VWarlock/MSX_WozBlaster/Images/Wozblaster_v1.2_PCB_top.jpg

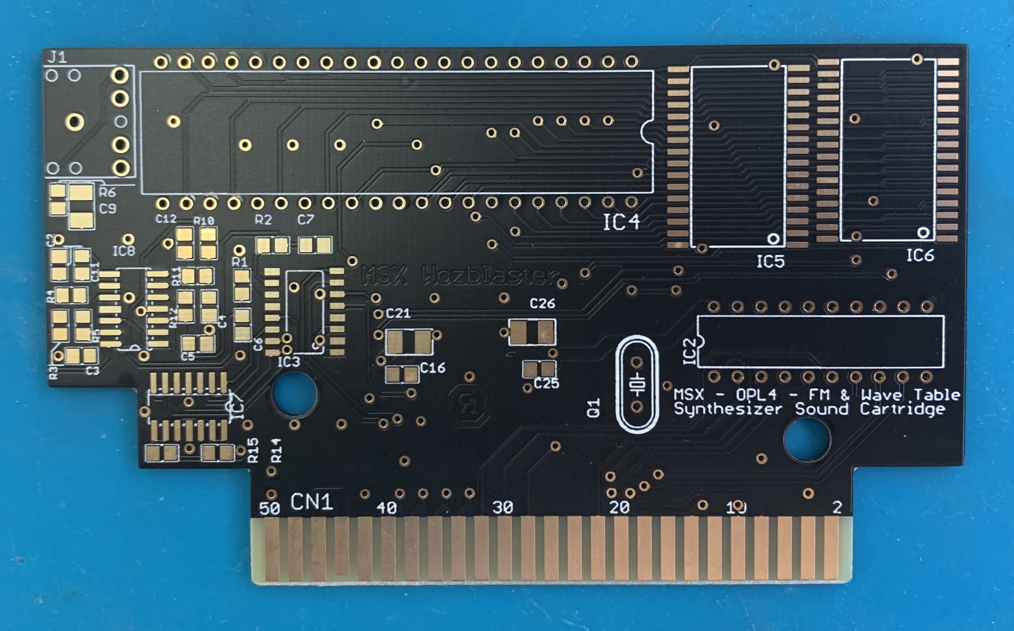
Images/Wozblaster_v1.2_PCB_top.jpg
