VWarlock/MSX_WozBlaster/Images/Wozblaster_v1.2_PCB_bot.jpg

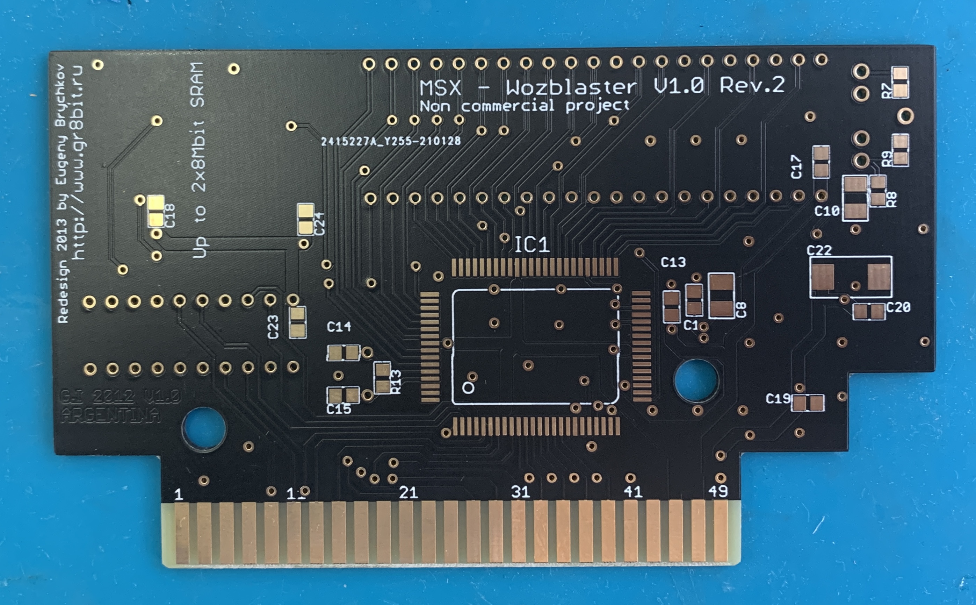
Images/Wozblaster_v1.2_PCB_bot.jpg
