VWarlock/MSX_WozBlaster/README.md

# MSX WozBlaster
MSX OPL4 FM &amp; Wavetable Sound Synthesizer

# WozBlaster version 1 Revision 2

All thruhole components was changed to SMT
