VWarlock/MSX_WozBlaster/Images/WozBlaster_v1_2_PCB.jpg

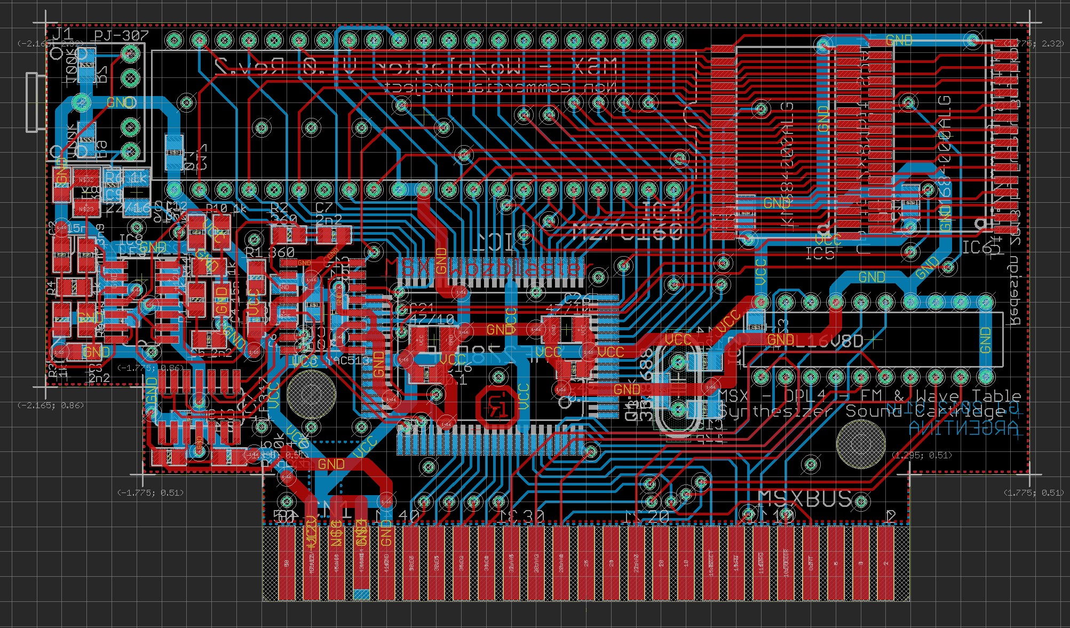
Images/WozBlaster_v1_2_PCB.jpg
