VWarlock/MSX_WozBlaster/Images/WozBlaster_v1_2_SCH.png

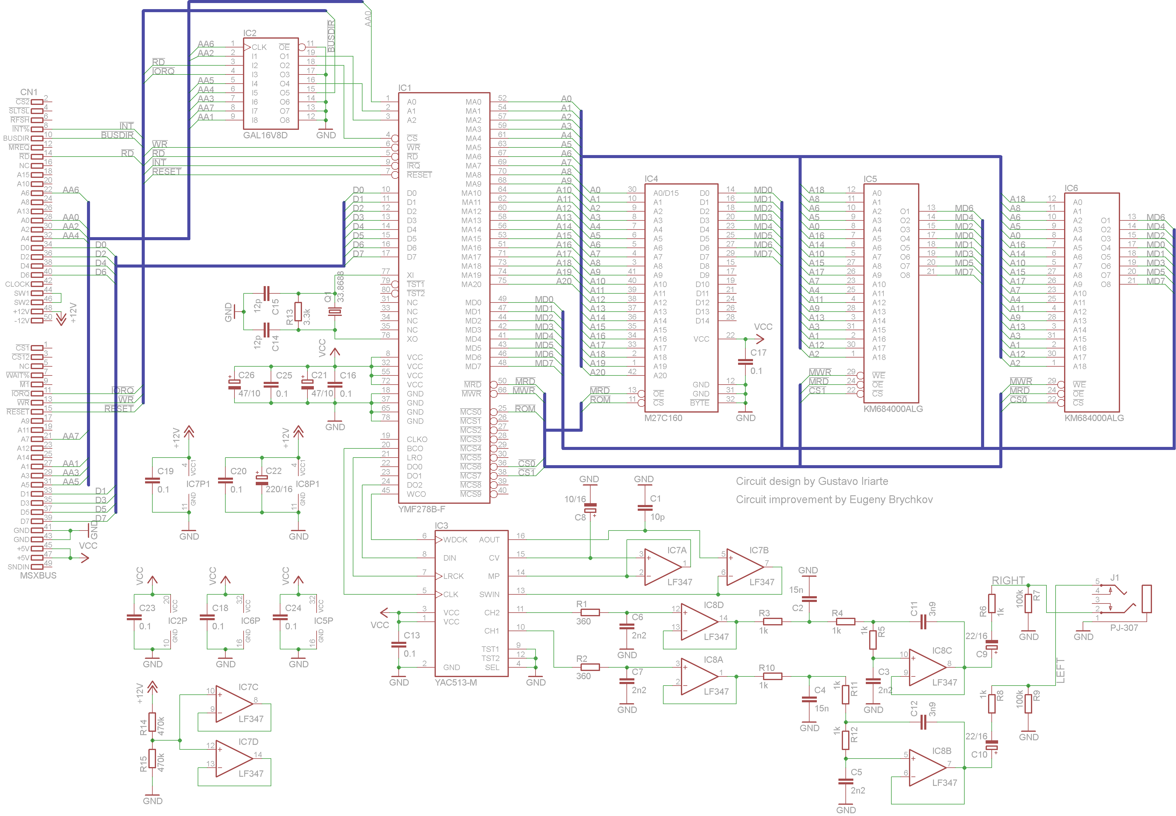
Images/WozBlaster_v1_2_SCH.png
