VWarlock/MSX_WozBlaster/Board/Wozblaster_v1.2.brd

## EAGLE design Board/Wozblaster_v1.2.brd (2023-05-25)

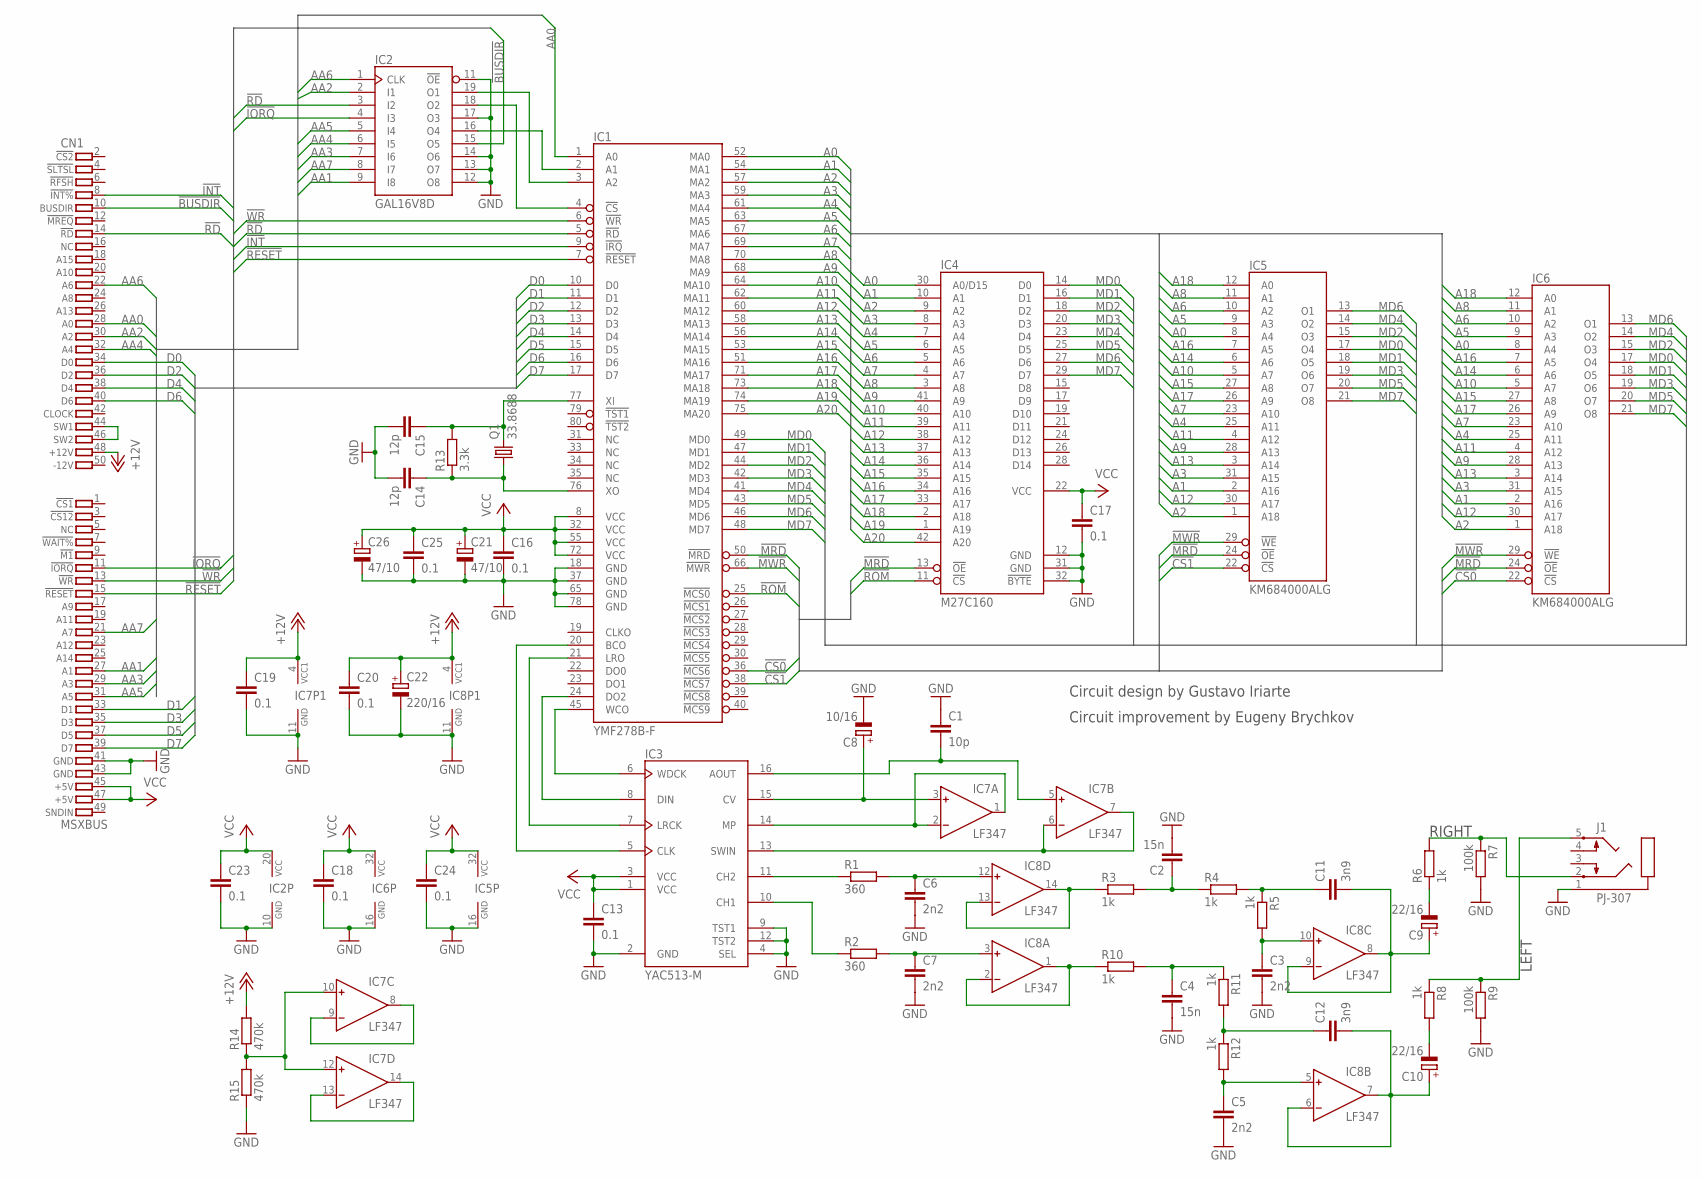
[picture p5: schematic Wozblaster_v1.2.sch]

Parts:
C1: 10p; C0805
C2, C4: 15n; C0805
C3, C5, C6, C7: 2n2; C0805
C8: 10/16; SMC_B
C9, C10: 22/16; SMC_B
C11, C12: 3n9; C0805
C13, C16, C17, C18, C19, C20, C23, C24, C25: 0.1; C0805
C14, C15: 12p; C0805
C21, C26: 47/10; SMC_B
C22: 220/16; SMC_E
CN1: MSXBUS; MSXBUS_EDGECONN
IC1: YMF278B-F; 80-QFP
IC2: GAL16V8D; DIL20
IC3: YAC513-M; 16SOP
IC4: M27C160; DIL42
IC5, IC6: KM684000ALG; SOP32L
IC7, IC8: LF347; SO14-2
J1: PJ-307
Q1: 33.8688; HC49/S
R1, R2: 360; R0805
R3, R4, R5, R6, R8, R10, R11, R12: 1k; R0805
R7, R9: 100k; R0805
R13: 3.3k; R0805
R14, R15: 470k; R0805

Connections:
!BUSDIR: CN1.10 (10.BUSDIR), IC2.15 (O5)
!CS0: IC1.36 (!MCS6), IC6.22 (!CS)
!CS1: IC1.38 (!MCS7), IC5.22 (!CS)
!INT: CN1.8 (8.!INT%), IC1.9 (!IRQ)
!IORQ: CN1.11 (11.!IORQ), IC2.4 (I3)
!MRD: IC1.50 (!MRD), IC4.13 (!OE), IC5.24 (!OE), IC6.24 (!OE)
!MWR: IC1.66 (!MWR), IC5.29 (!WE), IC6.29 (!WE)
!RD: CN1.14 (14.!RD), IC1.5 (!RD), IC2.3 (I2)
!RESET: CN1.15 (15.!RESET), IC1.7 (!RESET)
!ROM: IC1.25 (!MCS0), IC4.11 (!CS)
!WR: CN1.13 (13.!WR), IC1.6 (!WR)
+12V: C19.1, C20.1, C22.+, CN1.48 (48.+12V), IC7.4 (VCC), IC8.4 (VCC), R14.2
A0: IC1.52 (MA0), IC4.30 (A0/D15), IC5.8 (A4), IC6.8 (A4)
A1: IC1.54 (MA1), IC4.10 (A1), IC5.2 (A16), IC6.2 (A16)
A2: IC1.57 (MA2), IC4.9 (A2), IC5.1 (A18), IC6.1 (A18)
A3: IC1.59 (MA3), IC4.8 (A3), IC5.31 (A15), IC6.31 (A15)
A4: IC1.61 (MA4), IC4.7 (A4), IC5.25 (A11), IC6.25 (A11)
A5: IC1.63 (MA5), IC4.6 (A5), IC5.9 (A3), IC6.9 (A3)
A6: IC1.67 (MA6), IC4.5 (A6), IC5.10 (A2), IC6.10 (A2)
A7: IC1.69 (MA7), IC4.4 (A7), IC5.23 (A10), IC6.23 (A10)
A8: IC1.70 (MA8), IC4.3 (A8), IC5.11 (A1), IC6.11 (A1)
A9: IC1.68 (MA9), IC4.41 (A9), IC5.28 (A13), IC6.28 (A13)
A10: IC1.64 (MA10), IC4.40 (A10), IC5.5 (A7), IC6.5 (A7)
A11: IC1.62 (MA11), IC4.39 (A11), IC5.4 (A12), IC6.4 (A12)
A12: IC1.60 (MA12), IC4.38 (A12), IC5.30 (A17), IC6.30 (A17)
A13: IC1.58 (MA13), IC4.37 (A13), IC5.3 (A14), IC6.3 (A14)
A14: IC1.56 (MA14), IC4.36 (A14), IC5.6 (A6), IC6.6 (A6)
A15: IC1.53 (MA15), IC4.35 (A15), IC5.27 (A8), IC6.27 (A8)
A16: IC1.51 (MA16), IC4.34 (A16), IC5.7 (A5), IC6.7 (A5)
A17: IC1.71 (MA17), IC4.33 (A17), IC5.26 (A9), IC6.26 (A9)
A18: IC1.73 (MA18), IC4.2 (A18), IC5.12 (A0), IC6.12 (A0)
A19: IC1.74 (MA19), IC4.1 (A19)
A20: IC1.75 (MA20), IC4.42 (A20)
AA0: CN1.28 (28.A0), IC1.1 (A0)
AA1: CN1.27 (27.A1), IC2.9 (I8)
AA2: CN1.30 (30.A2), IC2.2 (I1)
AA3: CN1.29 (29.A3), IC2.7 (I6)
AA4: CN1.32 (32.A4), IC2.6 (I5)
AA5: CN1.31 (31.A5), IC2.5 (I4)
AA6: CN1.22 (22.A6), IC2.1 (CLK)
AA7: CN1.21 (21.A7), IC2.8 (I7)
D0: CN1.34 (34.D0), IC1.10 (D0)
D1: CN1.33 (33.D1), IC1.11 (D1)
D2: CN1.36 (36.D2), IC1.12 (D2)
D3: CN1.35 (35.D3), IC1.13 (D3)
D4: CN1.38 (38.D4), IC1.14 (D4)
D5: CN1.37 (37.D5), IC1.15 (D5)
D6: CN1.40 (40.D6), IC1.16 (D6)
D7: CN1.39 (39.D7), IC1.17 (D7)
GND: C1.1, C2.2, C3.2, C4.2, C5.2, C6.2, C7.2, C8.-, C13.2, C14.2, C15.2, C16.2, C17.2, C18.2, C19.2, C20.2, C21.-, C22.-, C23.2, C24.2, C25.2, C26.-, CN1.41 (41.GND), CN1.43 (43.GND), IC1.18 (GND), IC1.37 (GND), IC1.65 (GND), IC1.78 (GND), IC2.10 (GND), IC2.11 (!OE), IC2.12 (O8), IC2.13 (O7), IC2.14 (O6), IC2.17 (O3), IC3.2 (GND), IC3.4 (SEL), IC3.9 (TST1), IC3.12 (TST2), IC4.12 (GND), IC4.31 (GND), IC4.32 (!BYTE), IC5.16 (GND), IC6.16 (GND), IC7.11 (GND), IC8.11 (GND), J1.1, R7.2, R9.2, R15.1
MD0: IC1.49 (MD0), IC4.14 (D0), IC5.17 (O4), IC6.17 (O4)
MD1: IC1.47 (MD1), IC4.16 (D1), IC5.18 (O5), IC6.18 (O5)
MD2: IC1.44 (MD2), IC4.18 (D2), IC5.15 (O3), IC6.15 (O3)
MD3: IC1.42 (MD3), IC4.20 (D3), IC5.19 (O6), IC6.19 (O6)
MD4: IC1.41 (MD4), IC4.23 (D4), IC5.14 (O2), IC6.14 (O2)
MD5: IC1.43 (MD5), IC4.25 (D5), IC5.20 (O7), IC6.20 (O7)
MD6: IC1.46 (MD6), IC4.27 (D6), IC5.13 (O1), IC6.13 (O1)
MD7: IC1.48 (MD7), IC4.29 (D7), IC5.21 (O8), IC6.21 (O8)
unnamed: C5.1, IC8.5 (IN+), R12.2
unnamed: CN1.44 (44.SW1), CN1.46 (46.SW2)
unnamed: IC7.10 (IN+), IC7.12 (IN+), R14.1, R15.2
unnamed: IC7.8 (OUT), IC7.9 (IN-)
unnamed: IC7.13 (IN-), IC7.14 (OUT)
unnamed: IC1.3 (A2), IC2.19 (O1)
unnamed: IC1.4 (!CS), IC2.18 (O2)
unnamed: IC1.2 (A1), IC2.16 (O4)
unnamed: C1.2, IC3.16 (AOUT), IC7.5 (IN+)
unnamed: IC3.14 (MP), IC7.1 (OUT), IC7.2 (IN-)
unnamed: IC3.11 (CH2), R1.1
unnamed: C6.1, IC8.12 (IN+), R1.2
unnamed: IC8.13 (IN-), IC8.14 (OUT), R3.1
unnamed: C2.1, R3.2, R4.1
unnamed: C11.1, R4.2, R5.1
unnamed: C3.1, IC8.10 (IN+), R5.2
unnamed: C9.+, C11.2, IC8.8 (OUT), IC8.9 (IN-)
unnamed: C10.-, R8.2
unnamed: J1.2, R6.2, R7.1
unnamed: C7.1, IC8.3 (IN+), R2.2
unnamed: IC8.1 (OUT), IC8.2 (IN-), R10.1
unnamed: C4.1, R10.2, R11.1
unnamed: C12.1, R11.2, R12.1
unnamed: C10.+, C12.2, IC8.6 (IN-), IC8.7 (OUT)
unnamed: C9.-, R6.1
unnamed: J1.5, R8.1, R9.1
unnamed: IC3.10 (CH1), R2.1
unnamed: C8.+, IC3.15 (CV), IC7.3 (IN+)
unnamed: IC3.13 (SWIN), IC7.6 (IN-), IC7.7 (OUT)
unnamed: IC1.20 (BCO), IC3.5 (CLK)
unnamed: IC1.45 (WCO), IC3.6 (WDCK)
unnamed: IC1.21 (LRO), IC3.7 (LRCK)
unnamed: IC1.24 (DO2), IC3.8 (DIN)
unnamed: C15.1, IC1.77 (XI), Q1.2, R13.2
unnamed: C14.1, IC1.76 (XO), Q1.1, R13.1
VCC: C13.1, C16.1, C17.1, C18.1, C21.+, C23.1, C24.1, C25.1, C26.+, CN1.45 (45.+5V), CN1.47 (47.+5V), IC1.8 (VCC), IC1.32 (VCC), IC1.55 (VCC), IC1.72 (VCC), IC2.20 (VCC), IC3.1 (VCC), IC3.3 (VCC), IC4.22 (VCC), IC5.32 (VCC), IC6.32 (VCC)

Notes on the sheet:
Circuit design by Gustavo Iriarte
Circuit improvement by Eugeny Brychkov
LEFT
RIGHT

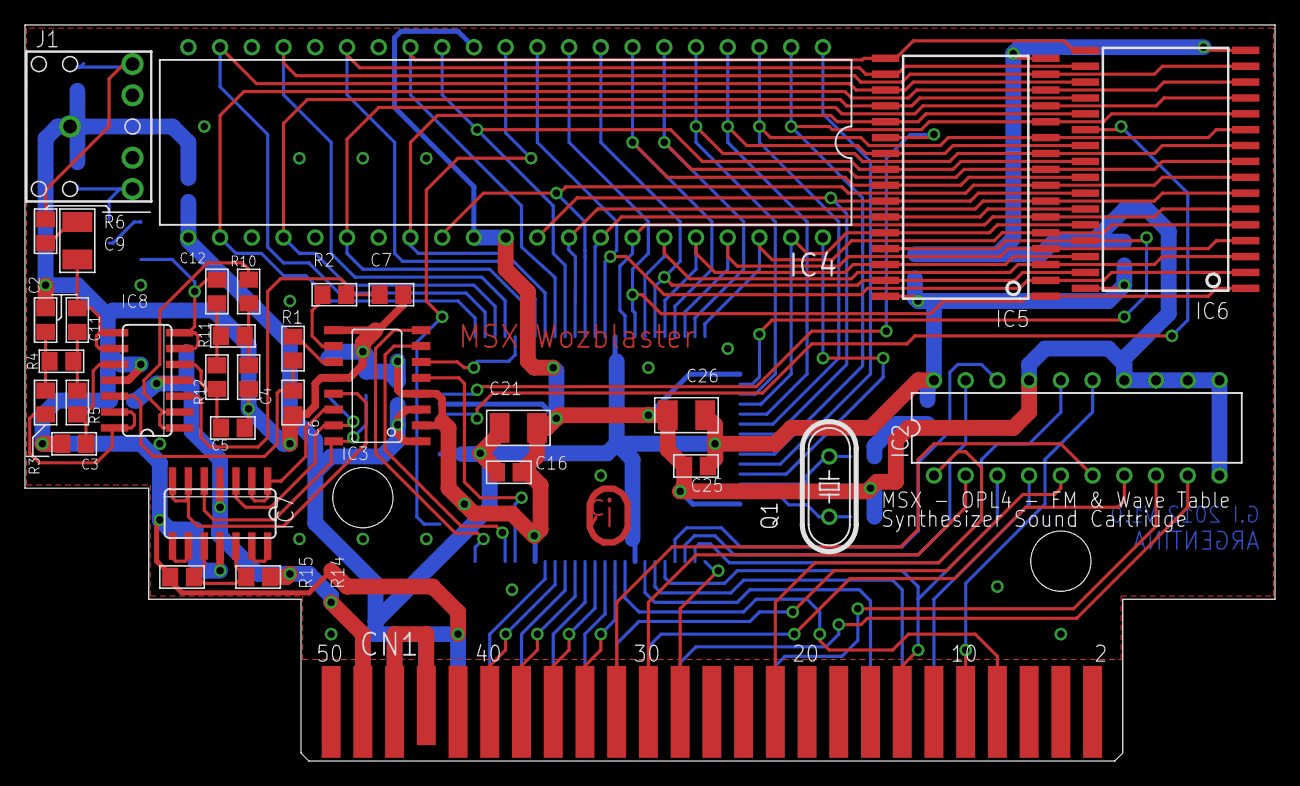
[picture p6: board Wozblaster_v1.2.brd from above]

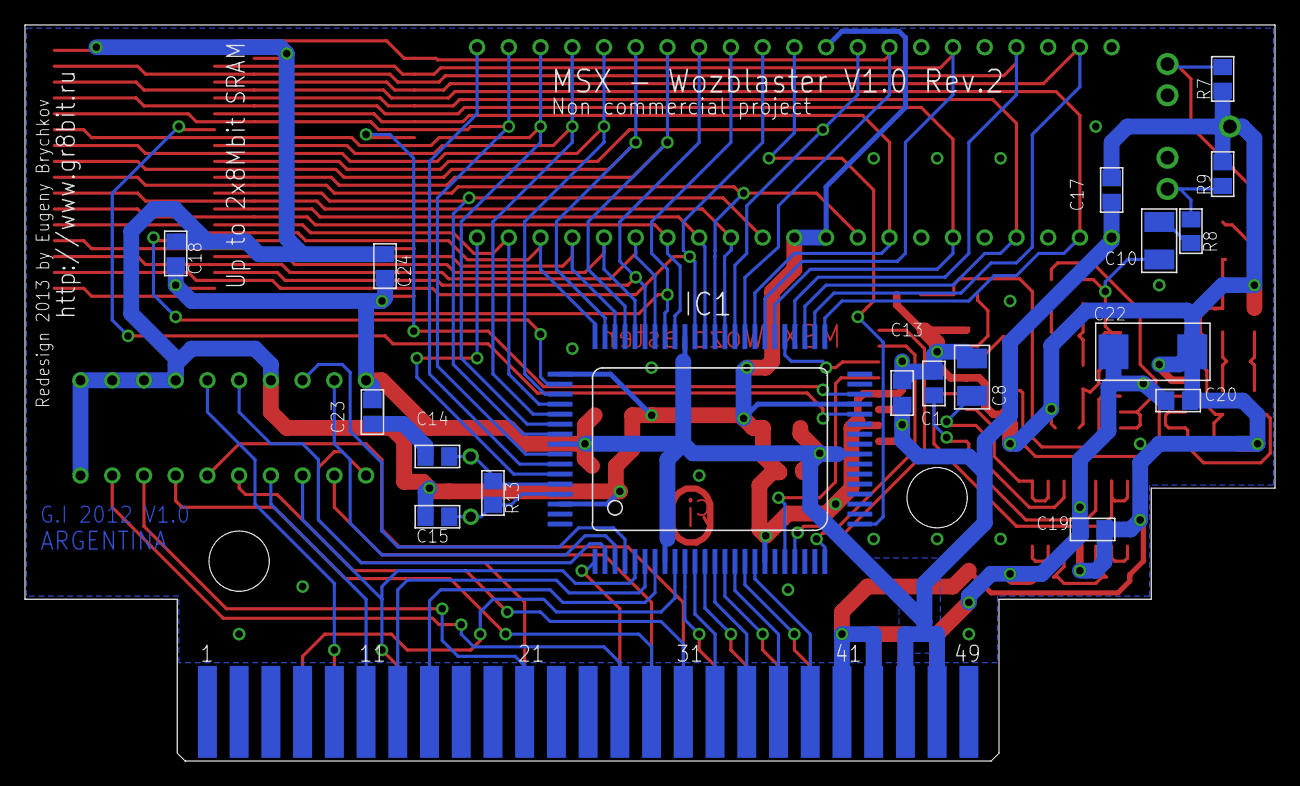
[picture p7: board Wozblaster_v1.2.brd from below]

Board: 2 copper layers, 100.1 x 58.9 mm, 52 parts (18 on the bottom side), 94 nets.
