VWarlock/MSX_WozBlaster/Firmware/GAL/ispLever files/pruebagal16v8d.fit.txt

$DEVICE         P16V8AS    fit pruebagal16v8d.tt3
$PINS   13  OA1:16   OA2:19   CS:18   BUSDIR:15   A1:9   A7:8   A3:7   
A4:6   A5:5   IORQ:4   RD:3   A2:2   A6:1   
--------------------------------------------------------------
