VWarlock/MSX_WozBlaster/Firmware/GAL/ispLever files/PruebaGAL16v8Dv2.syn.txt

JDF B
// Created by Version 1.5 
PROJECT PruebaGAL16v8D
DESIGN pruebagal16v8dv2 Normal
DEVKIT GAL16V8D-15LP
ENTRY ABEL/Schematic
MODULE wozblaster.sch
MODSTYLE wozblaster Normal
SYNTHESIS_TOOL Synplify
TOPMODULE wozblaster
