VWarlock/MSX_WozBlaster/(commit log)

2023-05-25 Board Revision 1
    [Wozblaster_v1.1.brd, Wozblaster_v1.1.sch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]
2023-05-25 Board Revision 2
    [Wozblaster_v1.1.brd, Wozblaster_v1.1.sch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]
